rishigovindnair-web/logic-chip-clock/bom.csv

Part | Purpose | Qty | Unit Price (USD) | Total (USD) | Vendor | Link | Variant | Ref
CD4060BE oscillator/divider IC (10-pack) | Crystal oscillator + 14-stage divider: 32.768 kHz down to 2 Hz (U1) | 1 | 1.76 | 1.76 | AliExpress | https://www.aliexpress.us/item/3256803148137606.html | CD4060BE | U1
CD4518BE dual BCD counter IC (5-pack) | Divide-by-2 and the six time counters (U2-U5) | 1 | 1.98 | 1.98 | AliExpress | https://www.aliexpress.us/item/3256812407957703.html | 5PCS CD4518BE DIP-14 | U2-U5
CD4511BE BCD to 7-segment decoder IC (5-pack) | Drives one display per digit (U6-U9) | 1 | 1.68 | 1.68 | AliExpress | https://www.aliexpress.us/item/3256812407656068.html | 5PCS CD4511BE DIP-16 | U6-U9
CD4081BE quad AND gate IC (5-pack) | Resets at :60 and at 24:00 (U10) | 1 | 1.88 | 1.88 | AliExpress | https://www.aliexpress.us/item/3256812908266140.html | CD4081BE | U10
0.56 in red 7-segment display, common cathode (5-pack) | The four digits (DS1-DS4) | 1 | 1.09 | 1.09 | AliExpress | https://www.aliexpress.us/item/3256810377855693.html | 0.56 Inch / Red / 1 Bit / Common Cathode | DS1-DS4
32.768 kHz crystal (20-pack) | Timebase (Y1) | 1 | 1.63 | 1.63 | AliExpress | https://www.aliexpress.us/item/2251800614977910.html | 3 X 8 32.768K | Y1
830 breadboard + MB102 power module + 65 jumper wires kit | Board 1, 5 V power from a wall adapter, wiring (BB1, PS1, W1) | 1 | 4.95 | 4.95 | AliExpress | https://www.aliexpress.us/item/3256805886191982.html | 830 White KIT | BB1, PS1, W1
830-point breadboard | Board 2 (BB2) | 1 | 3.25 | 3.25 | AliExpress | https://www.aliexpress.us/item/3256805886191982.html | Breadboard 830 | BB2
1/4W metal film resistor kit, 30 values x 10 (300 pcs) | Segment resistors, DP, oscillator feedback, SET pull-down (R1-R34) | 1 | 3.45 | 3.45 | AliExpress | https://www.aliexpress.us/item/3256811586219421.html | 300PCS bags | R1-R34
22 pF ceramic capacitor (50-pack) | Crystal load capacitors (C1-C2) | 1 | 2.10 | 2.10 | AliExpress | https://www.aliexpress.us/item/3256808410076521.html | 22P 50PCS | C1-C2
100 nF ceramic capacitor (50-pack) | Power decoupling, one per chip (C3-C12) | 1 | 2.09 | 2.09 | AliExpress | https://www.aliexpress.us/item/3256808410076521.html | 0.1uF 100nF 50PCS | C3-C12
