rishigovindnair-web/logic-chip-clock/schematic/logic-clock-schematic.pdf

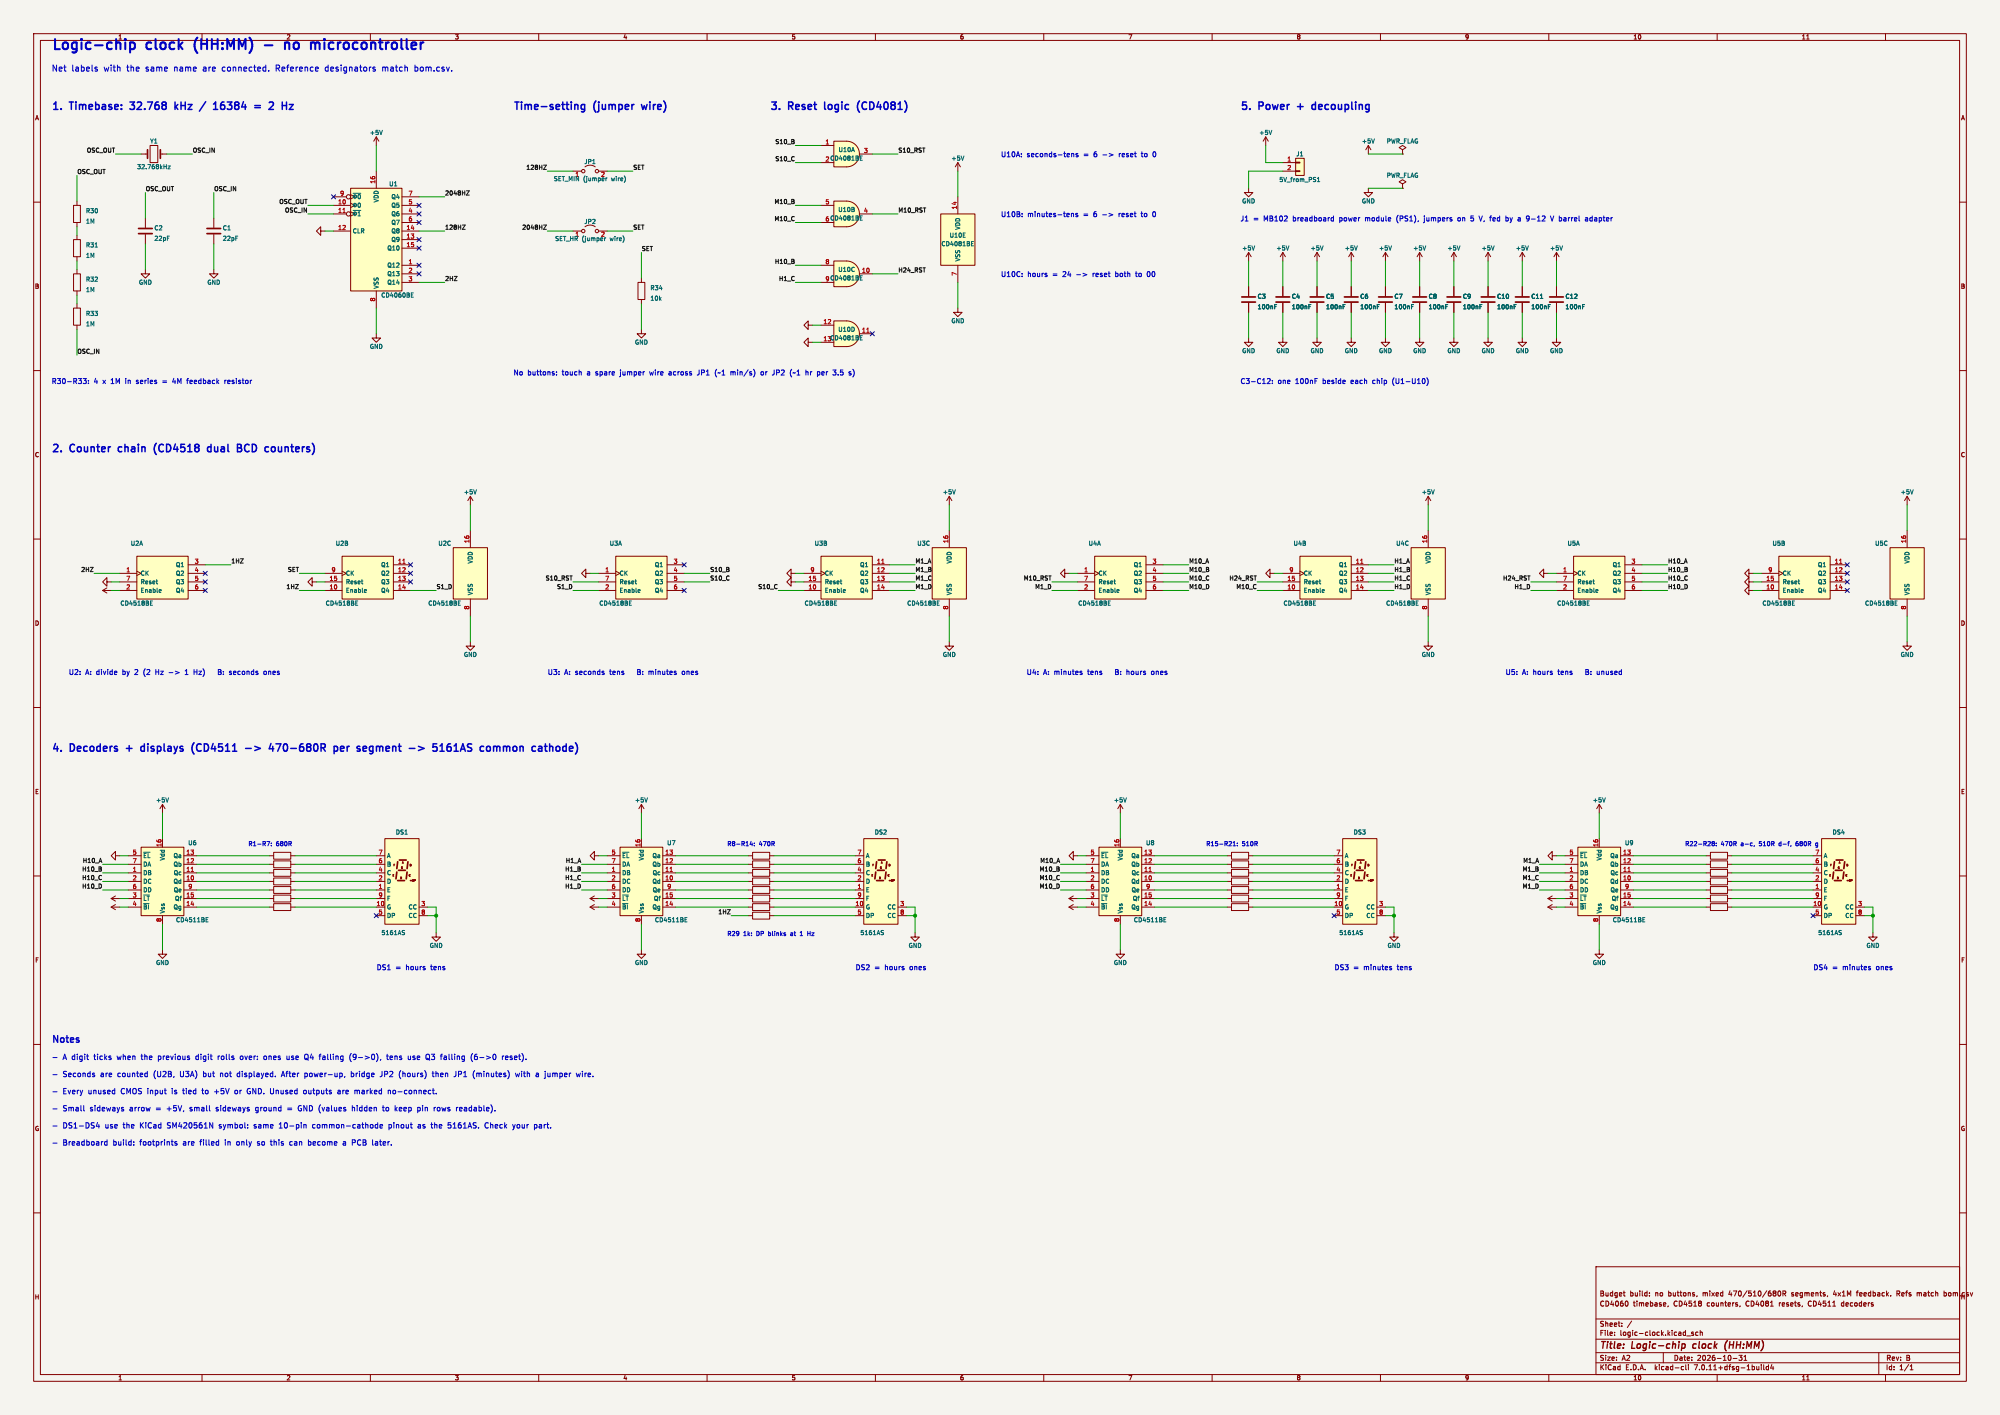
[picture p3: page 1]

- Every unused CMOS input is tied to +5V or GND. Unused outputs are marked no-connect.

- Small sideways arrow = +5V, small sideways ground = GND (values hidden to keep pin rows readable).
