rishigovindnair-web/logic-chip-clock/schematic/logic-clock.kicad_sch

## KiCad design schematic/logic-clock.kicad_sch (2026-11-02)

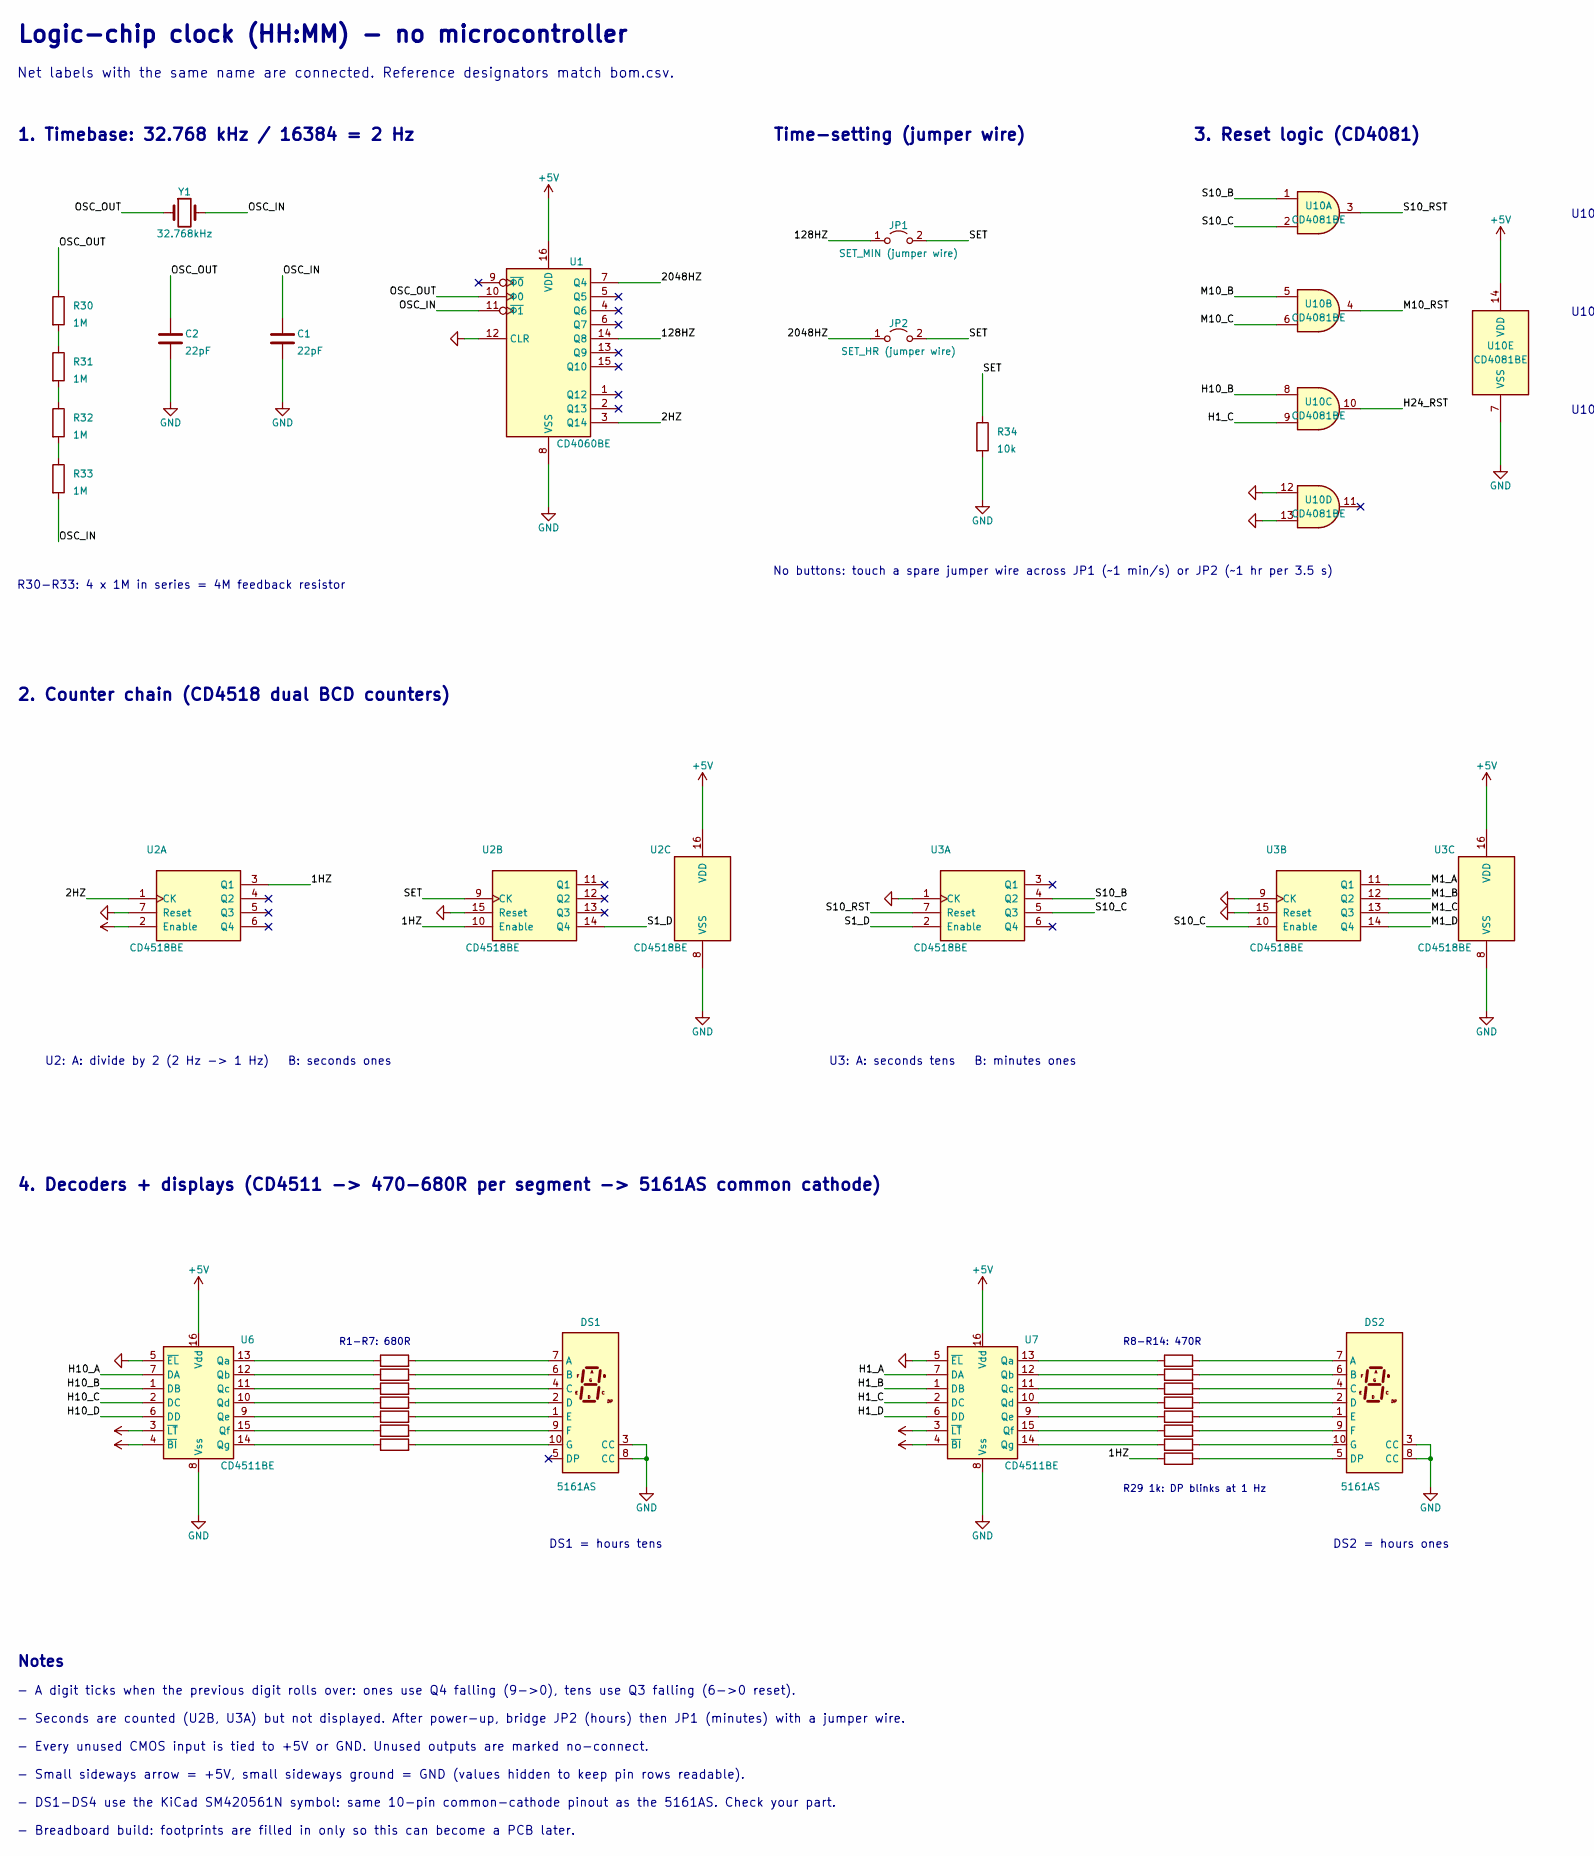
[picture p4: schematic logic-clock.kicad_sch, part in row 1, column 1]

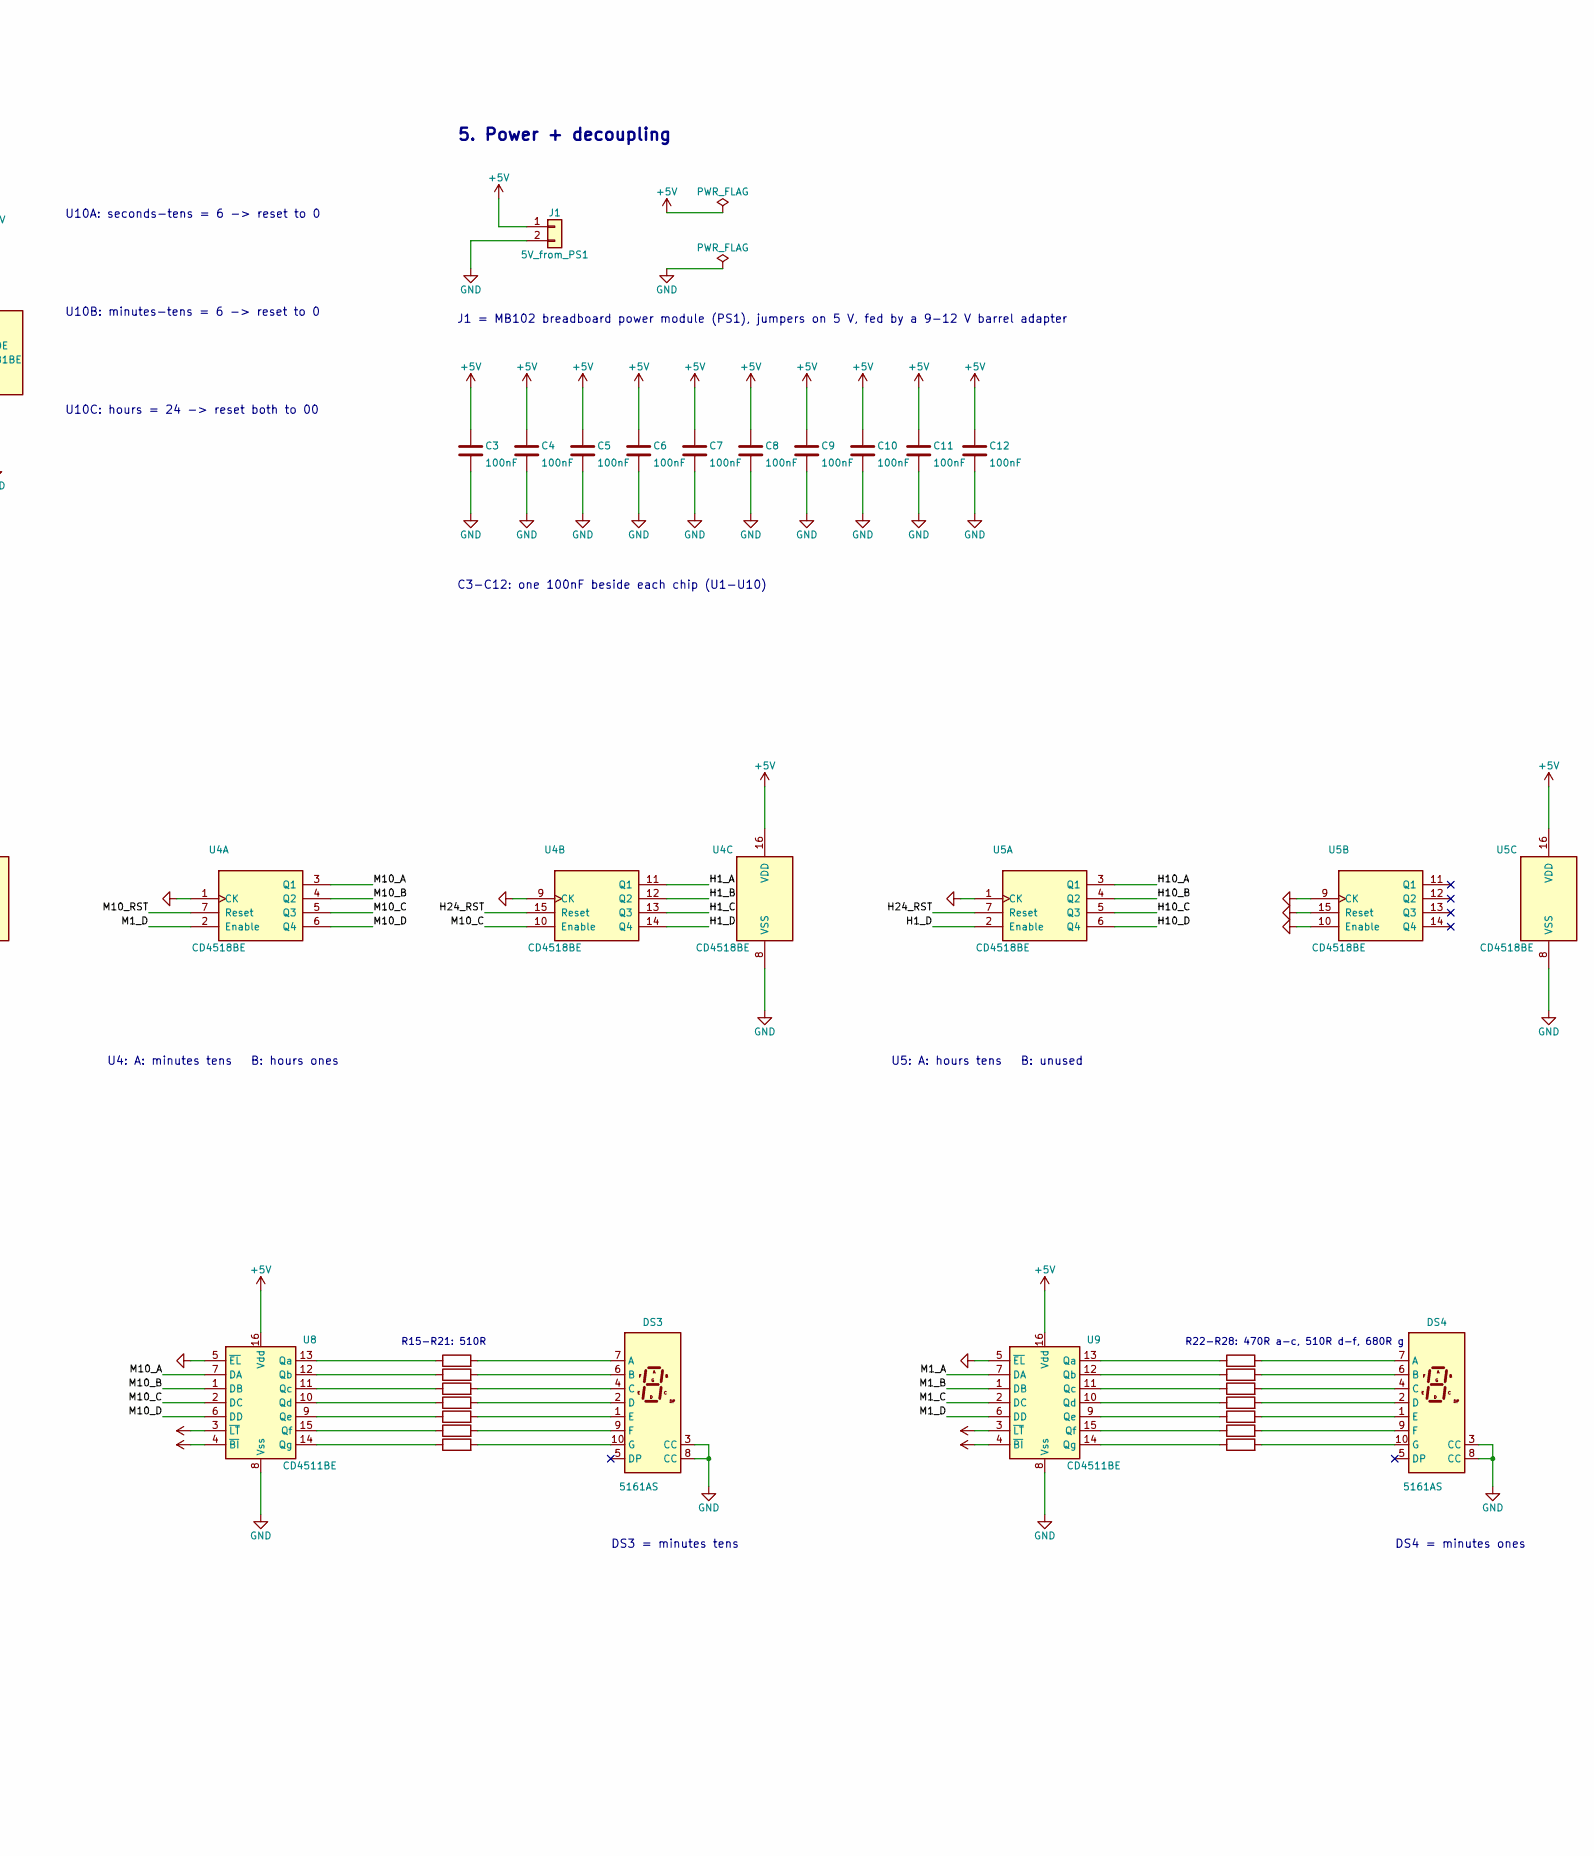
[picture p5: schematic logic-clock.kicad_sch, part in row 1, column 2]

Parts:
C1, C2: 22pF; C_Disc_D3.0mm_W1.6mm_P2.50mm
C3, C4, C5, C6, C7, C8, C9, C10, C11, C12: 100nF; C_Disc_D3.0mm_W1.6mm_P2.50mm
DS1, DS2, DS3, DS4: 5161AS; 7SegmentLED_LTS6760_LTS6780
J1: 5V_from_PS1; PinHeader_1x02_P2.54mm_Vertical
JP1: SET_MIN (jumper wire)
JP2: SET_HR (jumper wire)
R1, R2, R3, R4, R5, R6, R7, R28: 680; R_Axial_DIN0207_L6.3mm_D2.5mm_P7.62mm_Horizontal
R8, R9, R10, R11, R12, R13, R14, R22, R23, R24: 470; R_Axial_DIN0207_L6.3mm_D2.5mm_P7.62mm_Horizontal
R15, R16, R17, R18, R19, R20, R21, R25, R26, R27: 510; R_Axial_DIN0207_L6.3mm_D2.5mm_P7.62mm_Horizontal
R29: 1k; R_Axial_DIN0207_L6.3mm_D2.5mm_P7.62mm_Horizontal
R30, R31, R32, R33: 1M; R_Axial_DIN0207_L6.3mm_D2.5mm_P7.62mm_Horizontal
R34: 10k; R_Axial_DIN0207_L6.3mm_D2.5mm_P7.62mm_Horizontal
U1: CD4060BE; DIP-16_W7.62mm
U2, U3, U4, U5: CD4518BE; DIP-16_W7.62mm
U6, U7, U8, U9: CD4511BE; DIP-16_W7.62mm
U10: CD4081BE; DIP-14_W7.62mm
Y1: 32.768kHz; Crystal_C38-LF_D3.0mm_L8.0mm_Horizontal

Connections:
1HZ: R29.1, U2.3 (Q1), U2.10 (Enable)
2HZ: U1.3 (Q14), U2.1 (CK)
128HZ: JP1.1 (A), U1.14 (Q8)
2048HZ: JP2.1 (A), U1.7 (Q4)
+5V: C3.1, C4.1, C5.1, C6.1, C7.1, C8.1, C9.1, C10.1, C11.1, C12.1, J1.1, U1.16 (VDD), U2.2 (Enable), U2.16 (VDD), U3.16 (VDD), U4.16 (VDD), U5.16 (VDD), U6.3 (~LT), U6.4 (~BI), U6.16 (Vdd), U7.3 (~LT), U7.4 (~BI), U7.16 (Vdd), U8.3 (~LT), U8.4 (~BI), U8.16 (Vdd), U9.3 (~LT), U9.4 (~BI), U9.16 (Vdd), U10.14 (VDD)
GND: C1.2, C2.2, C3.2, C4.2, C5.2, C6.2, C7.2, C8.2, C9.2, C10.2, C11.2, C12.2, DS1.3 (CC), DS1.8 (CC), DS2.3 (CC), DS2.8 (CC), DS3.3 (CC), DS3.8 (CC), DS4.3 (CC), DS4.8 (CC), J1.2, R34.2, U1.8 (VSS), U1.12 (CLR), U2.7 (Reset), U2.8 (VSS), U2.15 (Reset), U3.1 (CK), U3.8 (VSS), U3.9 (CK), U3.15 (Reset), U4.1 (CK), U4.8 (VSS), U4.9 (CK), U5.1 (CK), U5.8 (VSS), U5.9 (CK), U5.10 (Enable), U5.15 (Reset), U6.5 (~EL), U6.8 (Vss), U7.5 (~EL), U7.8 (Vss), U8.5 (~EL), U8.8 (Vss), U9.5 (~EL), U9.8 (Vss), U10.7 (VSS), U10.12, U10.13
H1_A: U4.11 (Q1), U7.7 (DA)
H1_B: U4.12 (Q2), U7.1 (DB)
H1_C: U4.13 (Q3), U7.2 (DC), U10.9
H1_D: U4.14 (Q4), U5.2 (Enable), U7.6 (DD)
H10_A: U5.3 (Q1), U6.7 (DA)
H10_B: U5.4 (Q2), U6.1 (DB), U10.8
H10_C: U5.5 (Q3), U6.2 (DC)
H10_D: U5.6 (Q4), U6.6 (DD)
H24_RST: U4.15 (Reset), U5.7 (Reset), U10.10
M1_A: U3.11 (Q1), U9.7 (DA)
M1_B: U3.12 (Q2), U9.1 (DB)
M1_C: U3.13 (Q3), U9.2 (DC)
M1_D: U3.14 (Q4), U4.2 (Enable), U9.6 (DD)
M10_A: U4.3 (Q1), U8.7 (DA)
M10_B: U4.4 (Q2), U8.1 (DB), U10.5
M10_C: U4.5 (Q3), U4.10 (Enable), U8.2 (DC), U10.6
M10_D: U4.6 (Q4), U8.6 (DD)
M10_RST: U4.7 (Reset), U10.4
unnamed: DS1.1 (E), R5.2
unnamed: DS1.2 (D), R4.2
unnamed: DS1.4 (C), R3.2
unnamed: DS1.6 (B), R2.2
unnamed: DS1.7 (A), R1.2
unnamed: DS1.9 (F), R6.2
unnamed: DS1.10 (G), R7.2
unnamed: DS2.1 (E), R12.2
unnamed: DS2.2 (D), R11.2
unnamed: DS2.4 (C), R10.2
unnamed: DS2.5 (DP), R29.2
unnamed: DS2.6 (B), R9.2
unnamed: DS2.7 (A), R8.2
unnamed: DS2.9 (F), R13.2
unnamed: DS2.10 (G), R14.2
unnamed: DS3.1 (E), R19.2
unnamed: DS3.2 (D), R18.2
unnamed: DS3.4 (C), R17.2
unnamed: DS3.6 (B), R16.2
unnamed: DS3.7 (A), R15.2
unnamed: DS3.9 (F), R20.2
unnamed: DS3.10 (G), R21.2
unnamed: DS4.1 (E), R26.2
unnamed: DS4.2 (D), R25.2
unnamed: DS4.4 (C), R24.2
unnamed: DS4.6 (B), R23.2
unnamed: DS4.7 (A), R22.2
unnamed: DS4.9 (F), R27.2
unnamed: DS4.10 (G), R28.2
unnamed: R1.1, U6.13 (Qa)
unnamed: R2.1, U6.12 (Qb)
unnamed: R3.1, U6.11 (Qc)
unnamed: R4.1, U6.10 (Qd)
unnamed: R5.1, U6.9 (Qe)
unnamed: R6.1, U6.15 (Qf)
unnamed: R7.1, U6.14 (Qg)
unnamed: R8.1, U7.13 (Qa)
unnamed: R9.1, U7.12 (Qb)
unnamed: R10.1, U7.11 (Qc)
unnamed: R11.1, U7.10 (Qd)
unnamed: R12.1, U7.9 (Qe)
unnamed: R13.1, U7.15 (Qf)
unnamed: R14.1, U7.14 (Qg)
unnamed: R15.1, U8.13 (Qa)
unnamed: R16.1, U8.12 (Qb)
unnamed: R17.1, U8.11 (Qc)
unnamed: R18.1, U8.10 (Qd)
unnamed: R19.1, U8.9 (Qe)
unnamed: R20.1, U8.15 (Qf)
unnamed: R21.1, U8.14 (Qg)
unnamed: R22.1, U9.13 (Qa)
unnamed: R23.1, U9.12 (Qb)
unnamed: R24.1, U9.11 (Qc)
unnamed: R25.1, U9.10 (Qd)
unnamed: R26.1, U9.9 (Qe)
unnamed: R27.1, U9.15 (Qf)
unnamed: R28.1, U9.14 (Qg)
unnamed: R30.2, R31.1
unnamed: R31.2, R32.1
unnamed: R32.2, R33.1
OSC_IN: C1.1, R33.2, U1.11 (~Φ1), Y1.2
OSC_OUT: C2.1, R30.1, U1.10 (Φ0), Y1.1
S1_D: U2.14 (Q4), U3.2 (Enable)
S10_B: U3.4 (Q2), U10.1
S10_C: U3.5 (Q3), U3.10 (Enable), U10.2
S10_RST: U3.7 (Reset), U10.3
SET: JP1.2 (B), JP2.2 (B), R34.1, U2.9 (CK)

Notes on the sheet:
Logic-chip clock (HH:MM) - no microcontroller
Net labels with the same name are connected. Reference designators match bom.csv.
1. Timebase: 32.768 kHz / 16384 = 2 Hz
R30-R33: 4 x 1M in series = 4M feedback resistor
Time-setting (jumper wire)
No buttons: touch a spare jumper wire across JP1 (~1 min/s) or JP2 (~1 hr per 3.5 s)
3. Reset logic (CD4081)
U10A: seconds-tens = 6 -> reset to 0
U10B: minutes-tens = 6 -> reset to 0
U10C: hours = 24 -> reset both to 00
5. Power + decoupling
J1 = MB102 breadboard power module (PS1), jumpers on 5 V, fed by a 9-12 V barrel adapter
C3-C12: one 100nF beside each chip (U1-U10)
2. Counter chain (CD4518 dual BCD counters)
U2: A: divide by 2 (2 Hz -> 1 Hz) B: seconds ones
U3: A: seconds tens B: minutes ones
U4: A: minutes tens B: hours ones
U5: A: hours tens B: unused
4. Decoders + displays (CD4511 -> 470-680R per segment -> 5161AS common cathode)
R1-R7: 680R
DS1 = hours tens
R8-R14: 470R
R29 1k: DP blinks at 1 Hz
DS2 = hours ones
R15-R21: 510R
DS3 = minutes tens
R22-R28: 470R a-c, 510R d-f, 680R g
DS4 = minutes ones
Notes
- A digit ticks when the previous digit rolls over: ones use Q4 falling (9->0), tens use Q3 falling (6->0 reset).
- Seconds are counted (U2B, U3A) but not displayed. After power-up, bridge JP2 (hours) then JP1 (minutes) with a jumper wire.
- Every unused CMOS input is tied to +5V or GND. Unused outputs are marked no-connect.
- Small sideways arrow = +5V, small sideways ground = GND (values hidden to keep pin rows readable).
- DS1-DS4 use the KiCad SM420561N symbol: same 10-pin common-cathode pinout as the 5161AS. Check your part.
- Breadboard build: footprints are filled in only so this can become a PCB later.
