rishigovindnair-web/logic-chip-clock/(commit log)

2026-11-02 Add README and bill of materials
    [bom.csv]
2026-11-02 Add KiCad schematic (rev B) and PDF
    [logic-clock.kicad_sch]
2026-11-02 Add schematic overview and build illustration
2026-11-02 Add Arduino Nano variant sketch
2026-11-02 Add Arduino Nano variant build guide
2026-11-02 List Arduino Nano variant in README contents
2026-11-02 Reformat bom.csv for Half Life import (parts only, unit prices)
    [bom.csv]
2026-11-02 Update BOM prices to Nov 1 checkout ($28.38 total)
    [bom.csv]
